ardakaslan/ee463-termproject/Dimmer Circuit.JPG

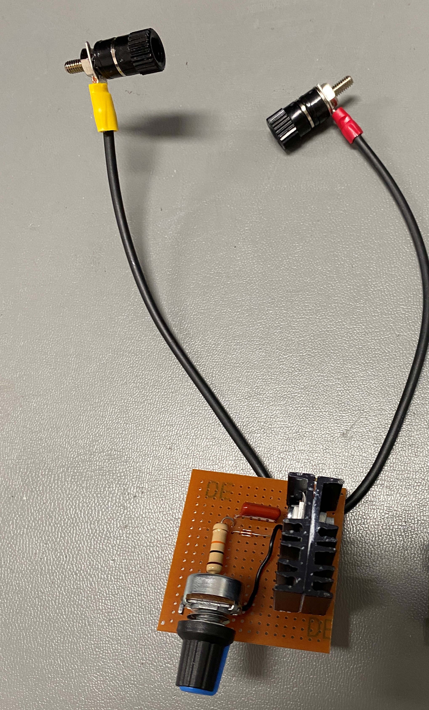
Dimmer Circuit.JPG
