ardakaslan/ee463-termproject/Kutu yapımı2.JPG

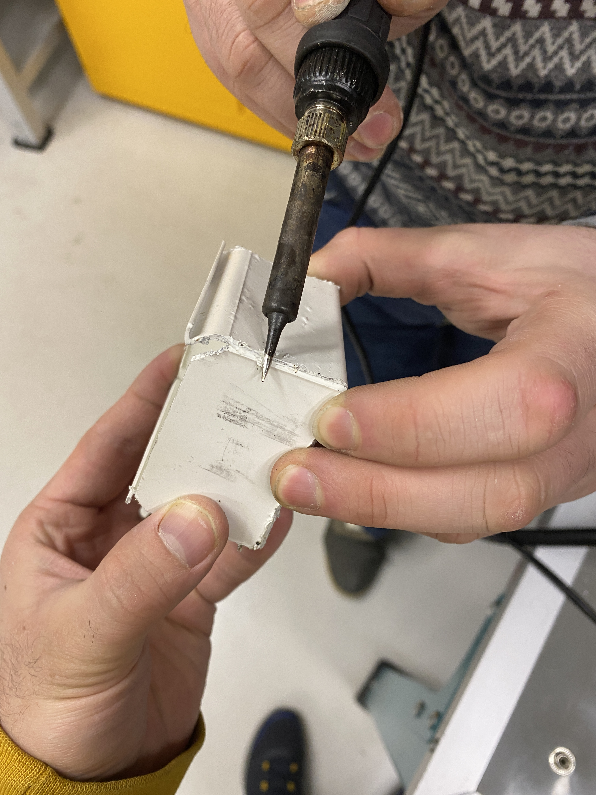
Kutu yapımı2.JPG
