ardakaslan/ee463-termproject/The tyrsitors control circuit with TCA785 _revised.pdf

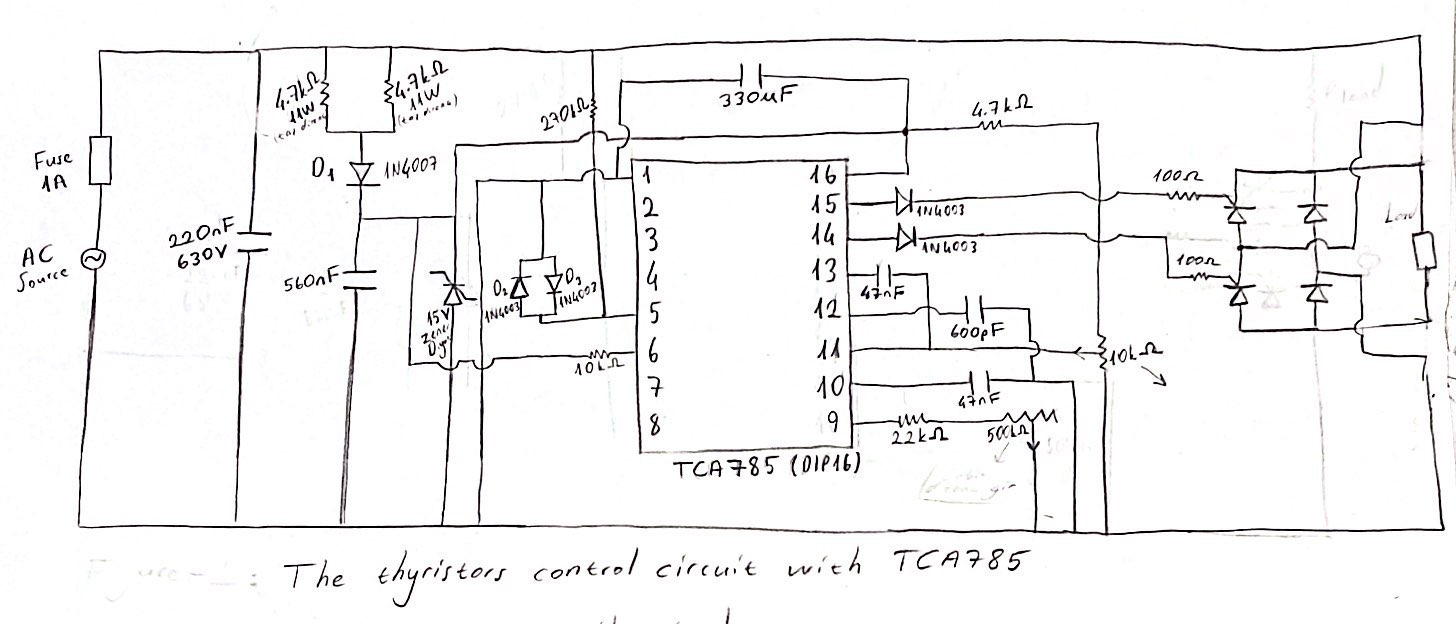
[picture p14: figure]
