ardakaslan/ee463-termproject/The tyrsitors control circuit with TCA785.pdf

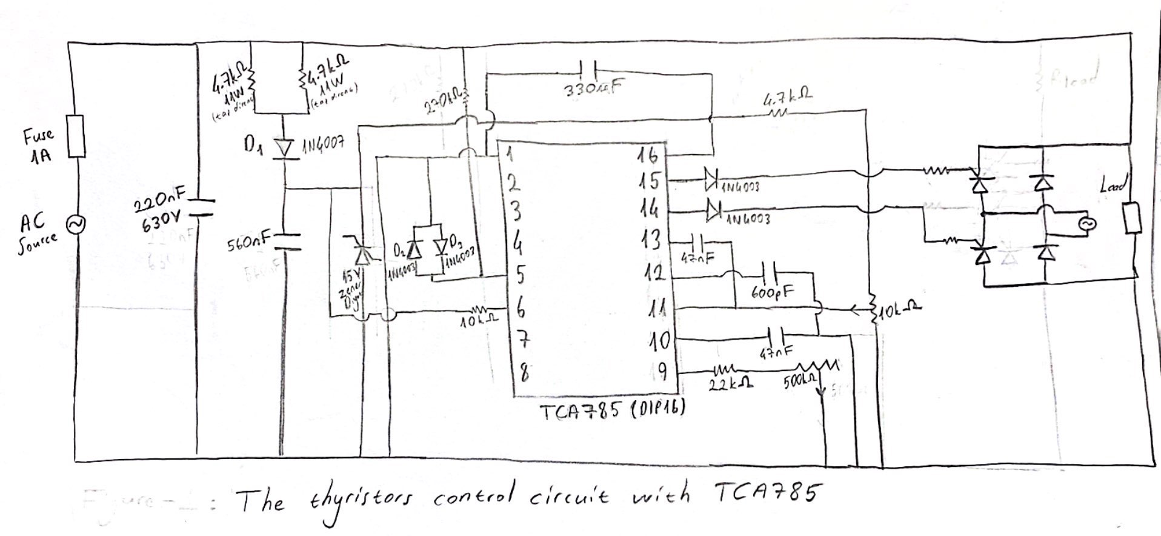
[picture p15: figure]
