ardakaslan/ee463-termproject/4.JPG

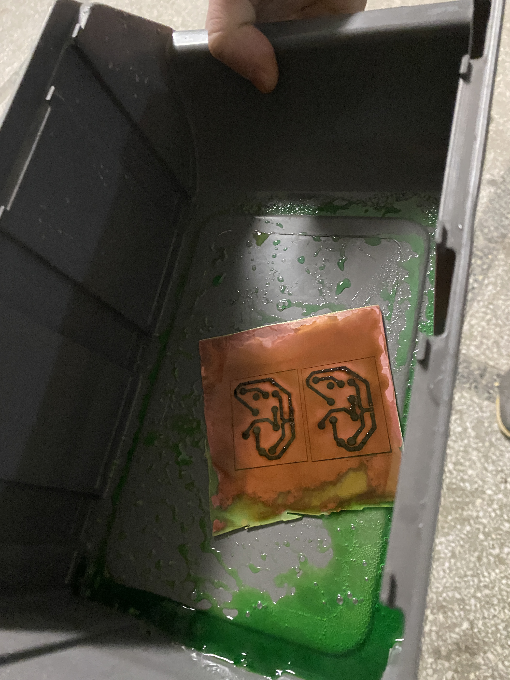
4.JPG
