ardakaslan/ee463-termproject/Control Firing Angle in Proteus.png

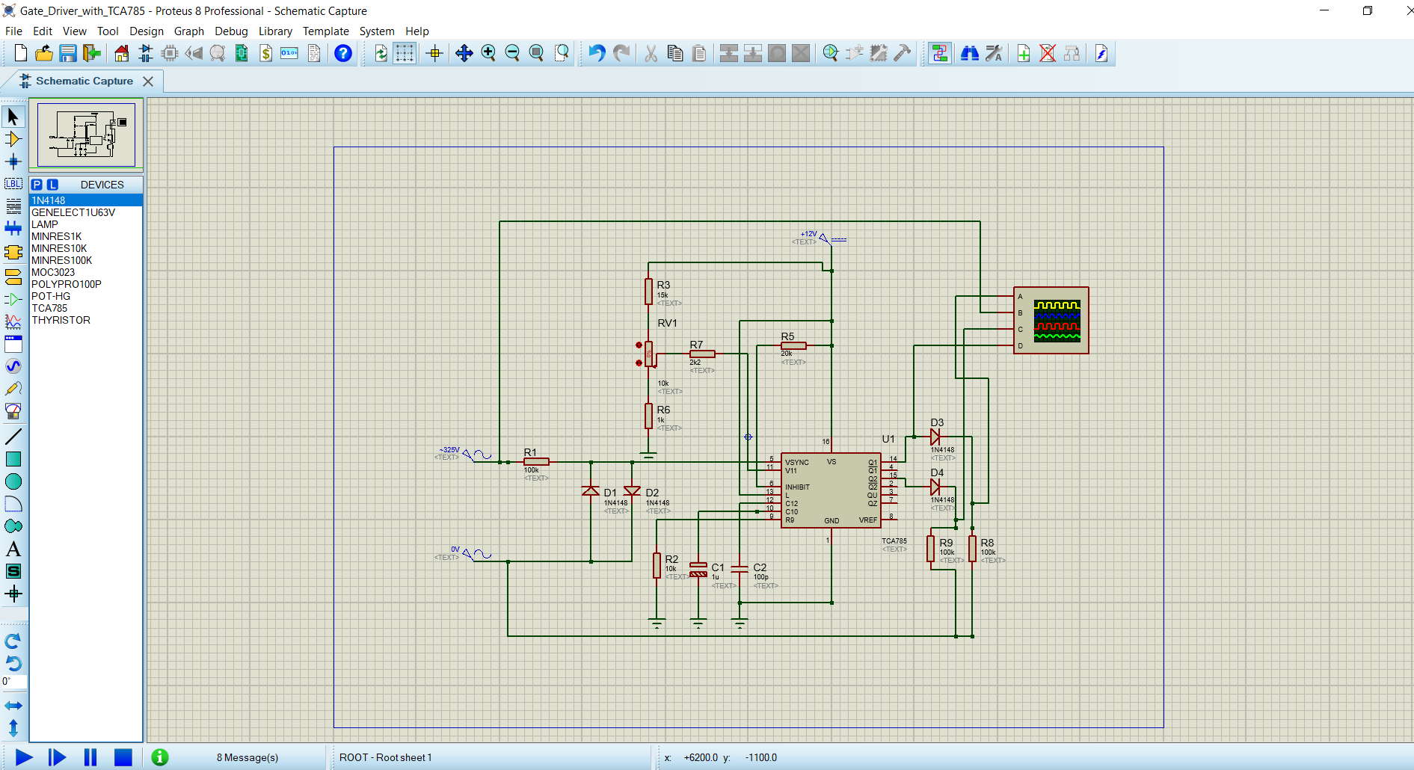
Control Firing Angle in Proteus.png
