ardakaslan/ee463-termproject/Dimmer Circuit 2.JPG

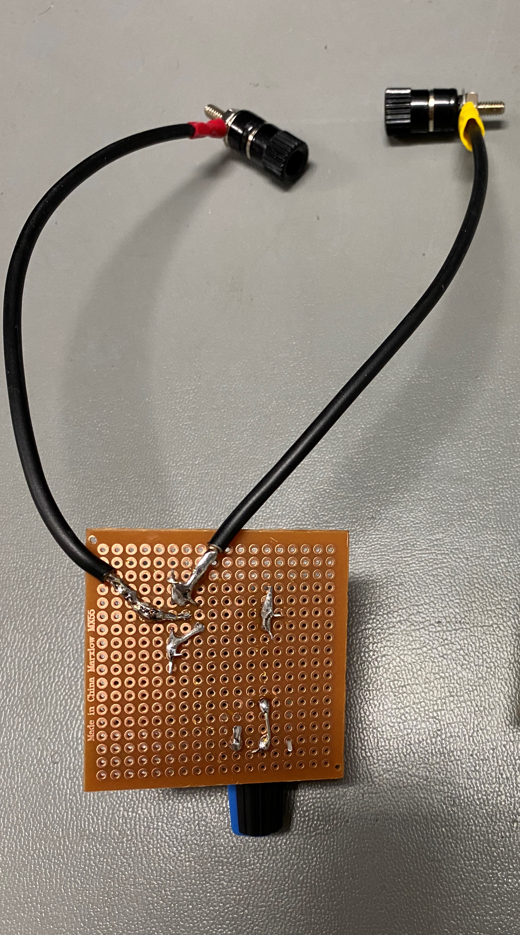
Dimmer Circuit 2.JPG
