ardakaslan/ee463-termproject/Dymmer Circuit PCB.jpeg

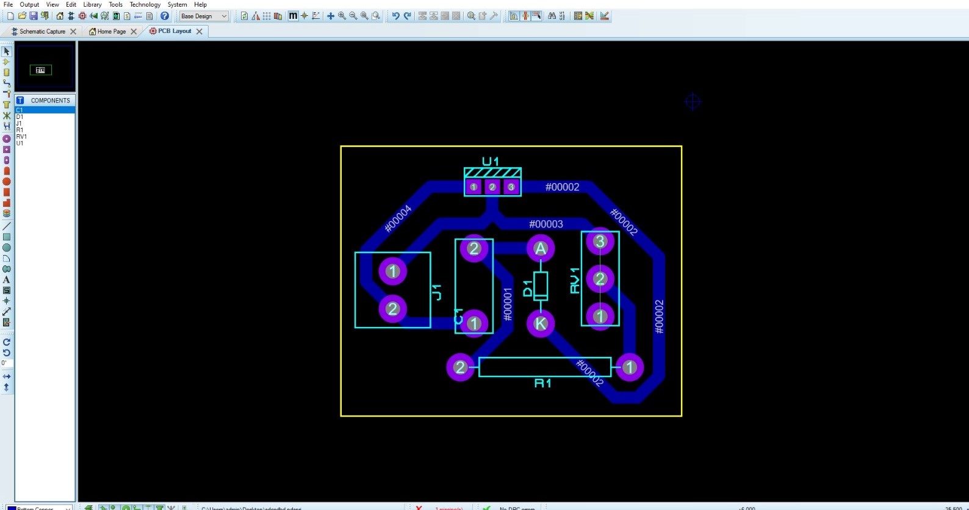
Dymmer Circuit PCB.jpeg
