ardakaslan/ee463-termproject/Dymmer Circuit Proteus.jpeg

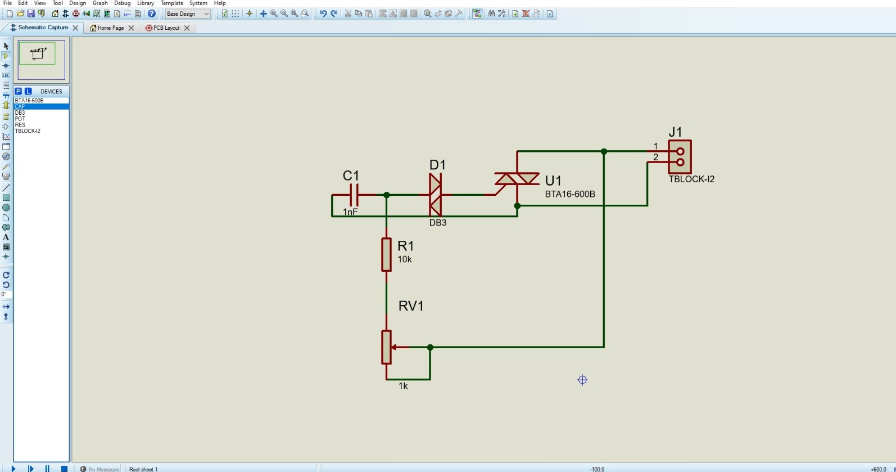
Dymmer Circuit Proteus.jpeg
