ardakaslan/ee463-termproject/pot30.png

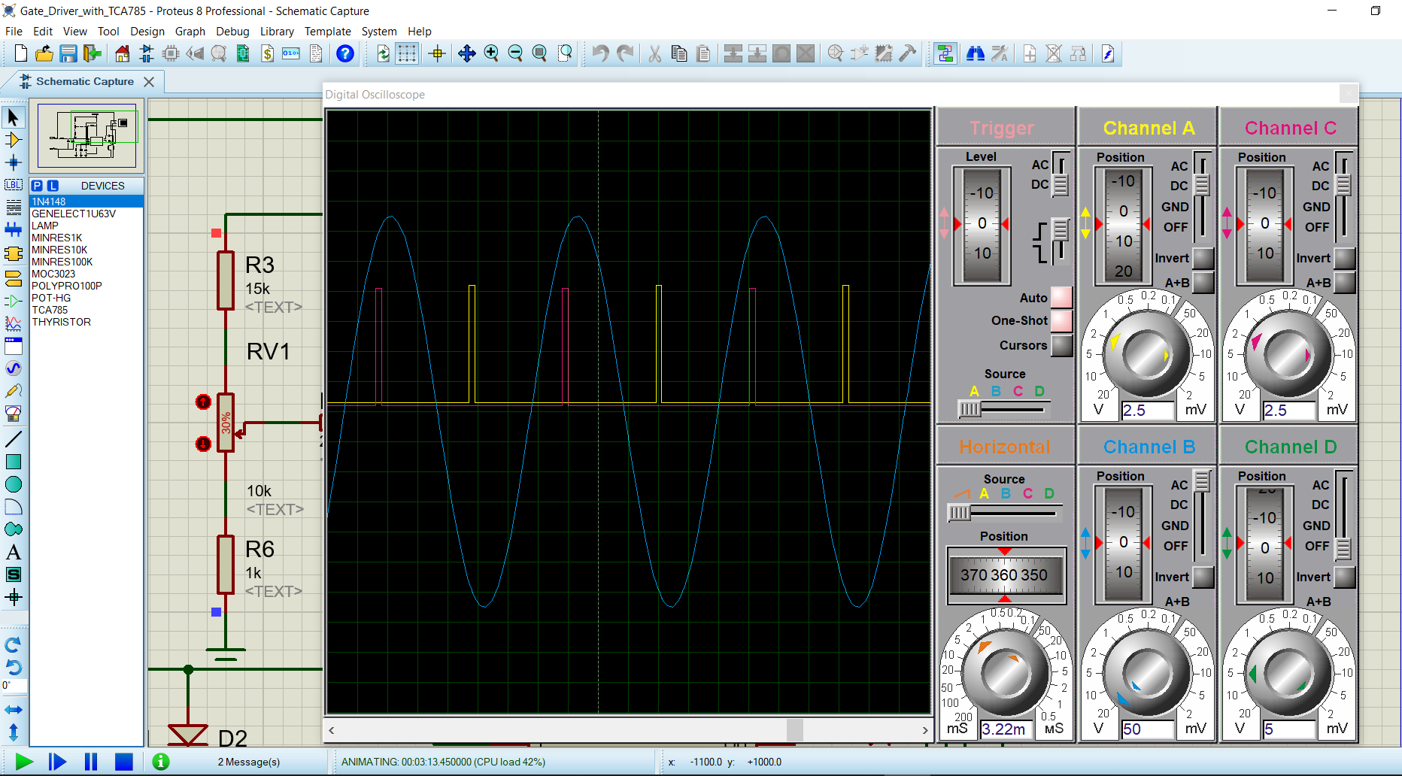
pot30.png
