ardakaslan/ee463-termproject/Thyristor Ignition Graphs with TCA785.png

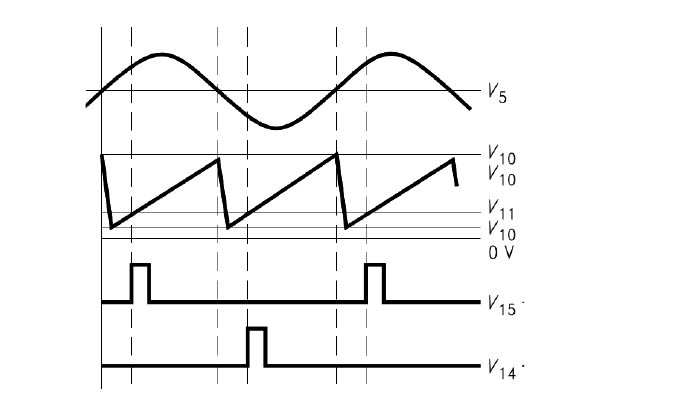
Thyristor Ignition Graphs with TCA785.png
