ardakaslan/ee463-termproject/Dimmer_Circuit.asc

C1: cap; 100n
L1: ind; 1m
R1: res; 10k
R2: res; 100
R3: res; 120
U1: DIAC
U2: TRIAC
V1: voltage; SINE(0 325 50)
Named nets: 0
.tran 0 0.1 0
.subckt TRIAC MT2 G MT1
.subckt DIAC T1 T2
.ends DIAC
.end TRIAC
