ardakaslan/ee463-termproject/(list of files, drawings)

Other design files:
Gate_Driver_with_TCA785.pdsprj
Thyristor.pdsprj
