ardakaslan/ee463-termproject/(commit log)

2021-12-27 The tyrsitors control circuit with TCA785 drawing
    The tyrsitors control circuit with TCA785 drawing
2021-12-28 The tyrsitors control circuit with TCA785 _revised
    The tyrsitors control circuit with TCA785 _drqwing
2021-12-30 Thyristor Control Circuit design in Proteus
    Thyristor Control Circuit design in Proteus first draft . we will arrange the output part
    [Thyristor.pdsprj]
2022-01-02 The Gate Driver Circuit Design with TCA785
    Proteus file
    [Gate_Driver_with_TCA785.pdsprj]
2022-01-02 The Gate Driver with TCA785
    By controlling the POT , we can arrange the firing angle.
2022-01-29 Dimmer Circuit Sketch in Proteus
    after changing our topology, the dimmer circuit sketched in proteus for PCB design
2022-01-29 The Dimmer Circuit Sketch
    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
2022-01-29 The PCB Sketch in Proteus
    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
2022-01-29 The dimmer circuit on perforated plaque front side
    The dimmer circuit on perforated plaque
2022-01-29 The dimmer circuit on perforated plaque back side
    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
2022-02-01 PCB Layout Printed version
    PCB Layout Printed version
2022-02-01 Drilling 1mm holes on PCB
    Drilling 1mm holes on PCB
2022-02-02 Setting the box of our circuit
    Setting the box of our circuit
2022-02-02 assembling the parts of our box
    assembling the parts of our box with the help of a soldering iron
2022-02-03 Our dymmer circuit Motor Test
    Our dymmer circuit Motor Test
2022-02-03 Dimmer Circuit Motor Test
    Dimmer Circuit Motor Test
