ardakaslan/ee463-termproject/2.JPG

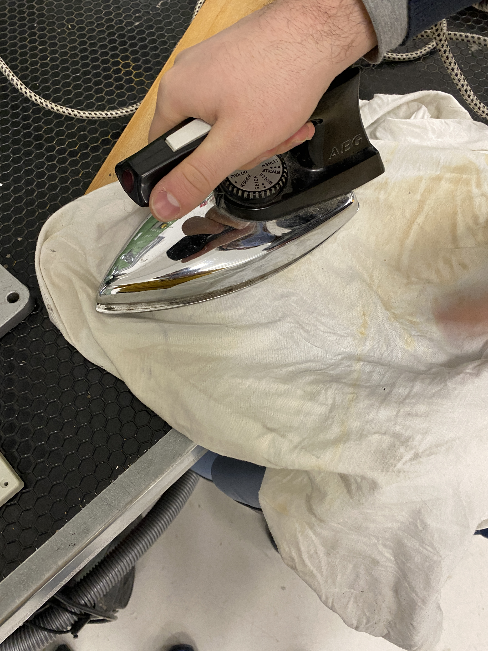
2.JPG
