ardakaslan/ee463-termproject/3.JPG

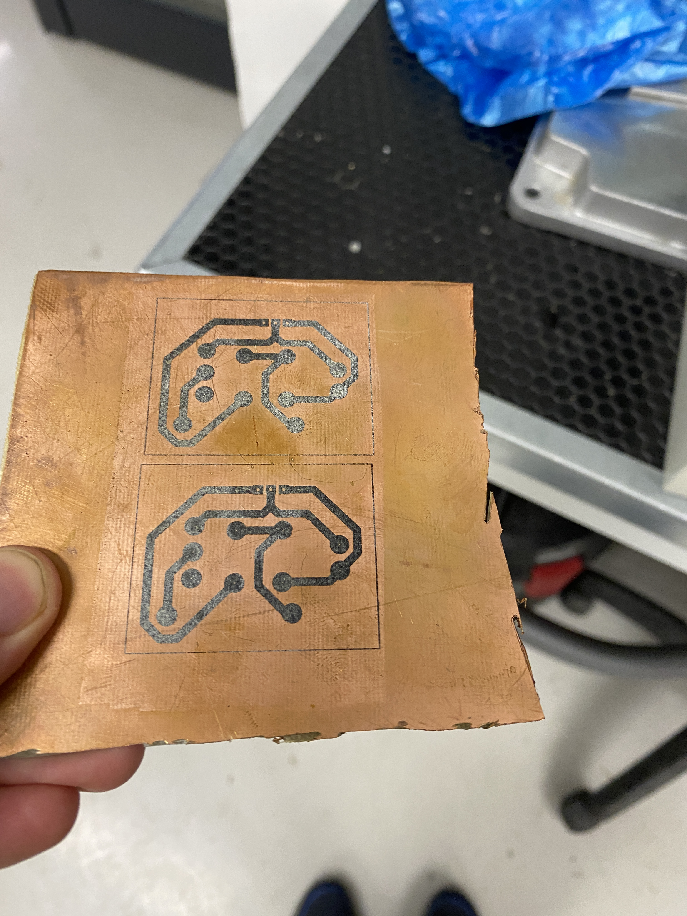
3.JPG
