ardakaslan/ee463-termproject/5.JPG

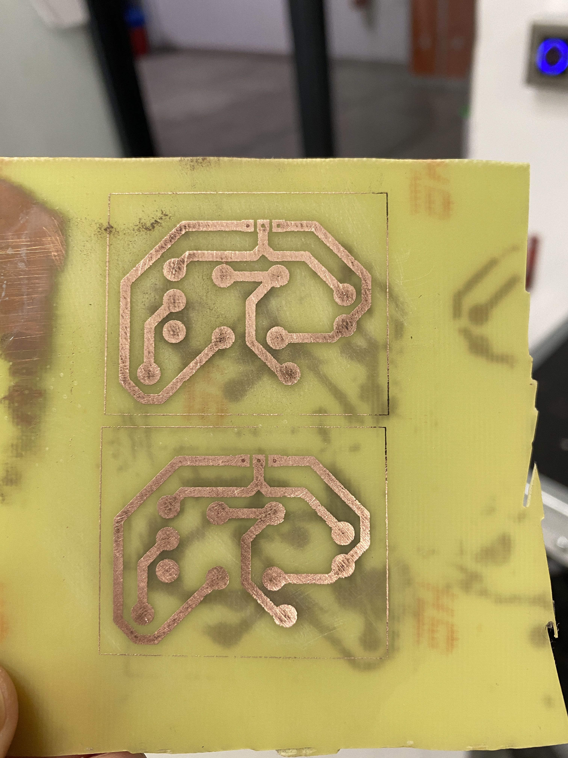
5.JPG
